LibreTactile/tact-io-sma/README.md

# tact-io-sma
**Open-source hardware** design of a simple tactile actuator mechanism driven by a Shape Memory Alloy (SMA) wire, tact-io for short.

Test 1.2.3.
