LibreTactile/tact-io-sma/docs/img/tact-io-sma-activation.webp

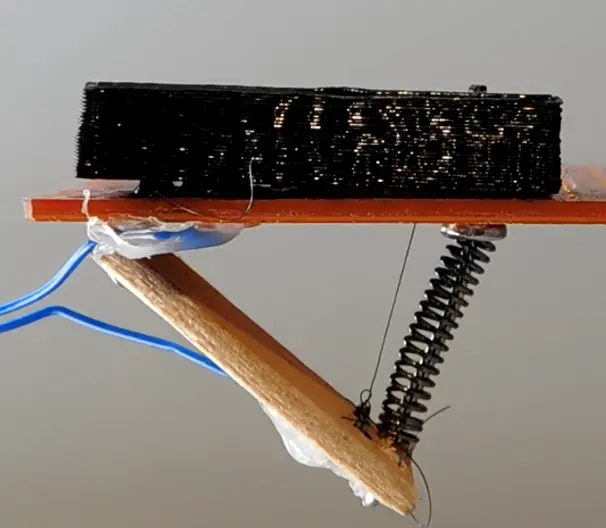
docs/img/tact-io-sma-activation.webp
