LibreTactile/tact-io-sma/source/case/topLidCase.FCStd

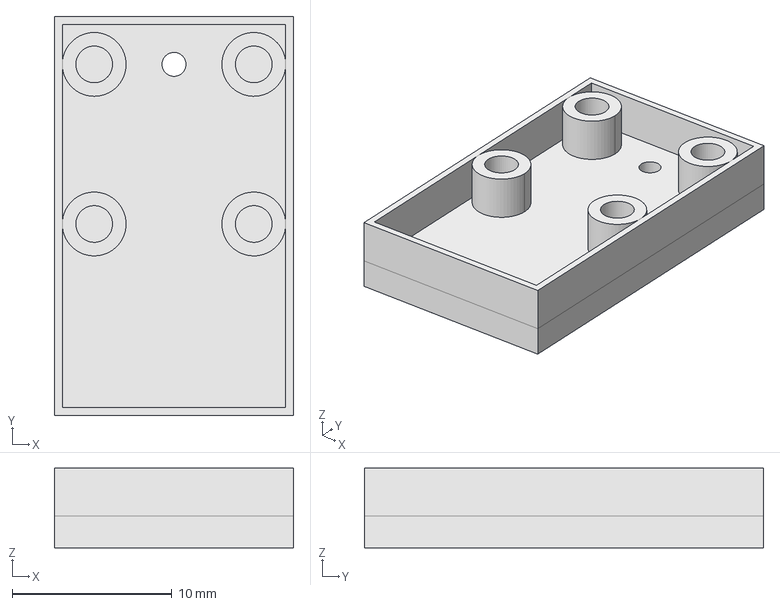
[picture p7: CAD file, 2022-04-25]
source/case/topLidCase.FCStd
15.0 x 25.0 x 5.00 mm
