LibreTactile/tact-io-sma/source/case/botomCase.FCStd

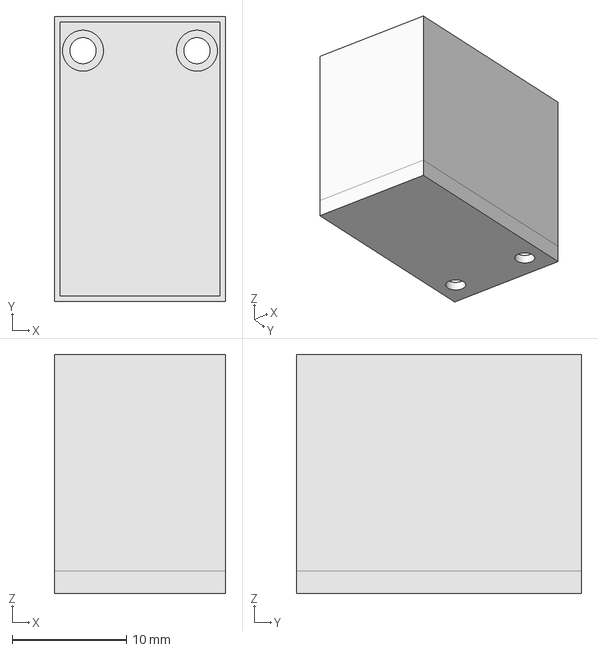
[picture p8: CAD file, 2022-04-25]
source/case/botomCase.FCStd
15.0 x 25.0 x 21.0 mm
