LibreTactile/tact-io-sma/docs/user-manual.md

(Pending)

device components
device functions
Installation
Operation
Device customization
Privacy and security disclaimer
