LibreTactile/tact-io-sma/(commit log)

2022-04-25 first branch upload
    [botomCase.FCStd, topLidCase.FCStd]
2022-04-25 power circuit calculations
2022-04-25 knot resource added
2022-06-08 Draft release
    [botomCase.FCStd, topLidCase.FCStd]
